wildcircuits/Cobble/Cobble-board-test/fab/Cobble-board-test-F_Cu.dxf

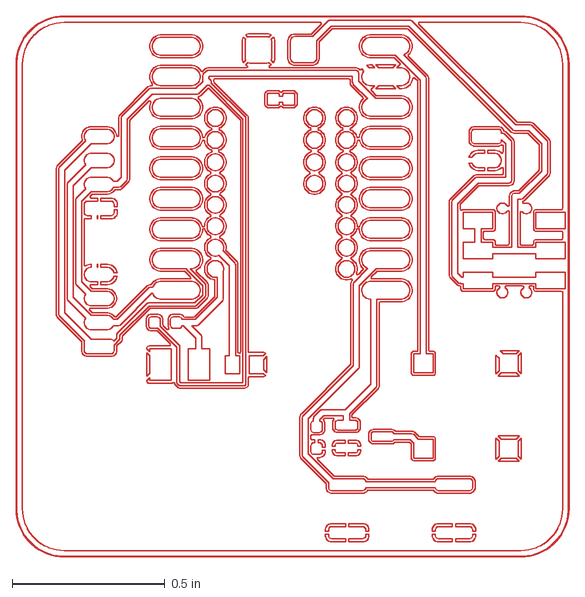
[picture p2: CAD file, 2026-10-19]
Cobble-board-test/fab/Cobble-board-test-F_Cu.dxf
1.81 x 1.77 in
