wildcircuits/Cobble/Cobble-board/fab/Cobble-board-Edge_Cuts.dxf

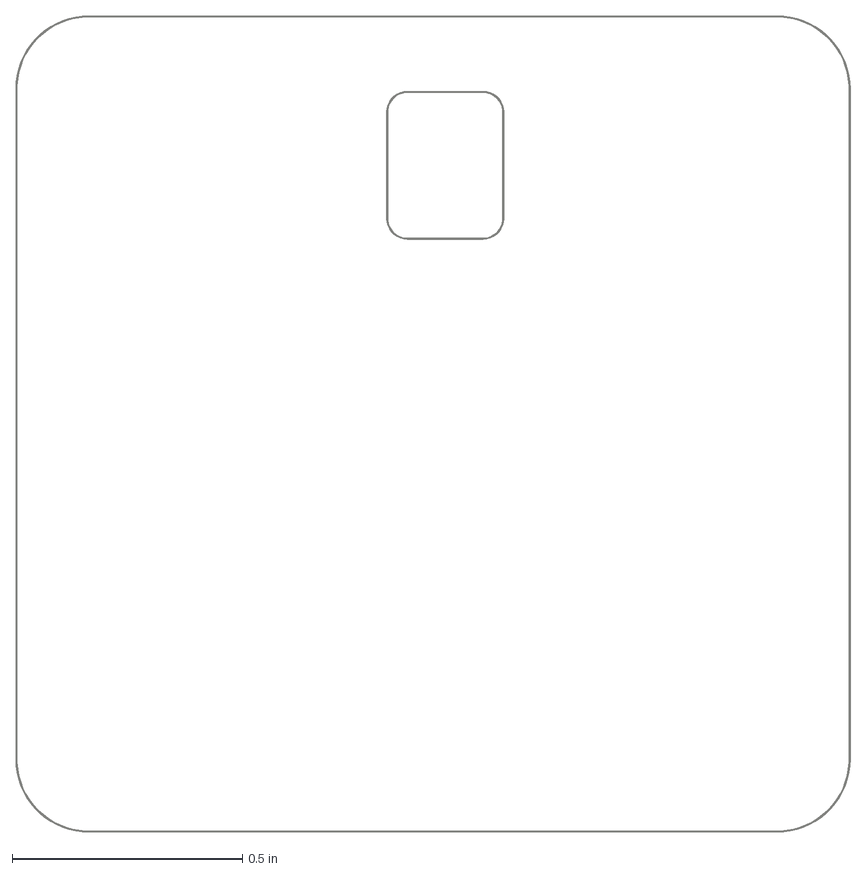
[picture p3: CAD file, 2026-11-10]
Cobble-board/fab/Cobble-board-Edge_Cuts.dxf
1.81 x 1.77 in
