wildcircuits/Cobble/Cobble-board-test/fab/Cobble-board-test-Edge_Cuts.dxf

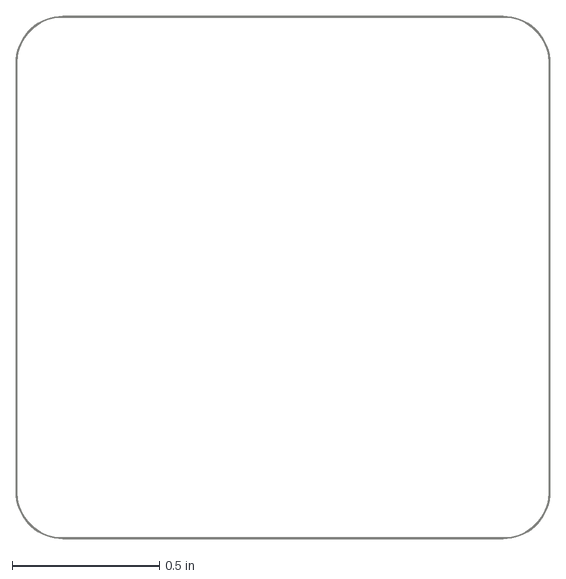
[picture p4: CAD file, 2026-10-12]
Cobble-board-test/fab/Cobble-board-test-Edge_Cuts.dxf
1.81 x 1.77 in
