wildcircuits/Cobble/Cobble-board/fab/Cobble-board-F_Cu.dxf

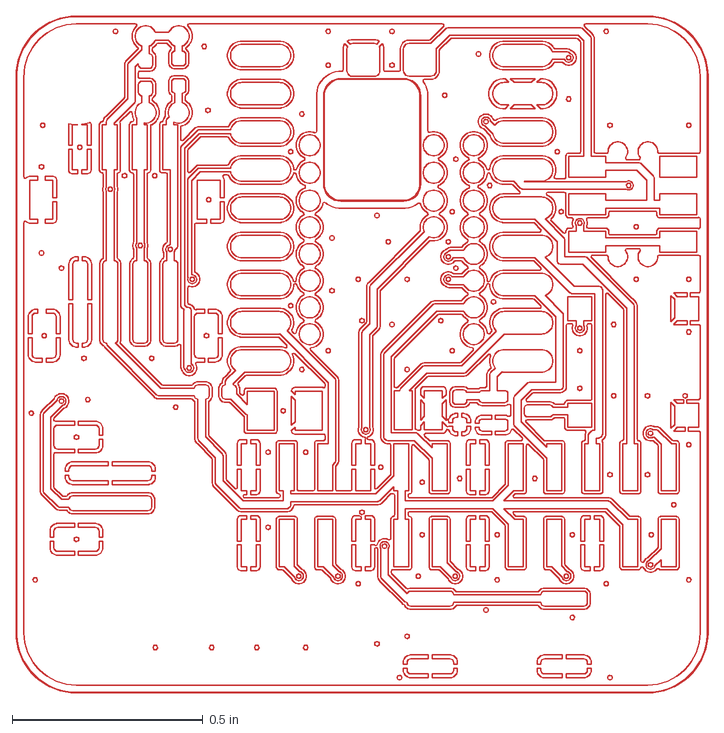
[picture p5: CAD file, 2026-11-10]
Cobble-board/fab/Cobble-board-F_Cu.dxf
1.81 x 1.77 in
