wildcircuits/Cobble/Cobble-board/fab/Cobble-board-B_Cu.dxf

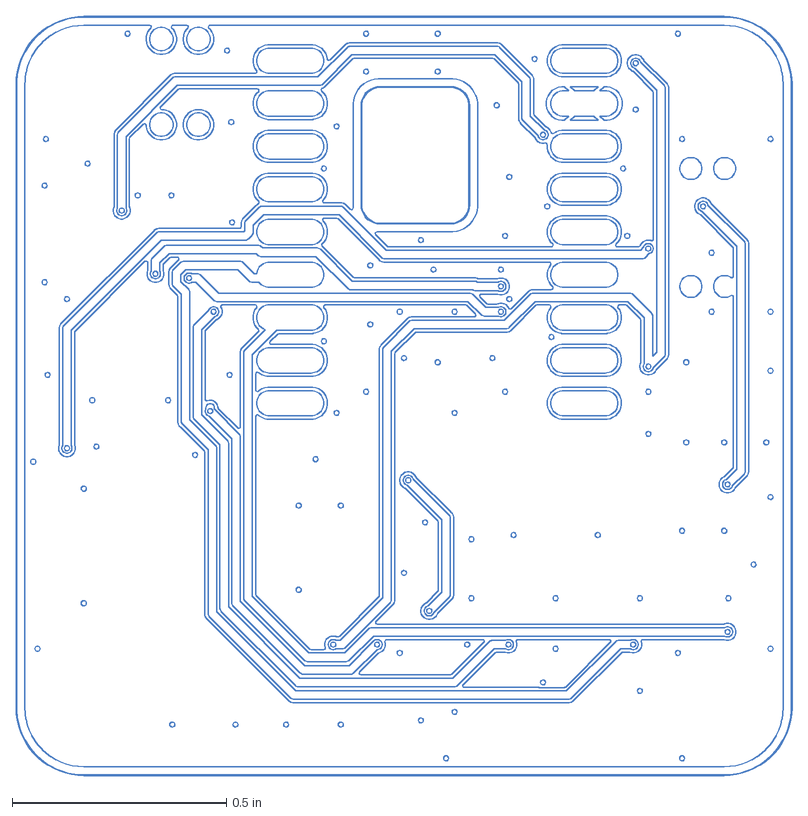
[picture p6: CAD file, 2026-11-10]
Cobble-board/fab/Cobble-board-B_Cu.dxf
1.81 x 1.77 in
