wildcircuits/Cobble/(list of files, cad)

Other CAD files:
Cobble-board-test/fab/Cobble-board-test-F_Paste.dxf
Cobble-board-test/fab/Cobble-board-test-F_Silkscreen.dxf
Cobble-board/fab/Cobble-board-B_Mask.dxf
Cobble-board/fab/Cobble-board-B_Paste.dxf
Cobble-board/fab/Cobble-board-B_Silkscreen.dxf
Cobble-board/fab/Cobble-board-F_Mask.dxf
Cobble-board/fab/Cobble-board-F_Paste.dxf
Cobble-board/fab/Cobble-board-F_Silkscreen.dxf
