wildcircuits/Cobble/Cobble-board-test/Cobble-board-test.pdf

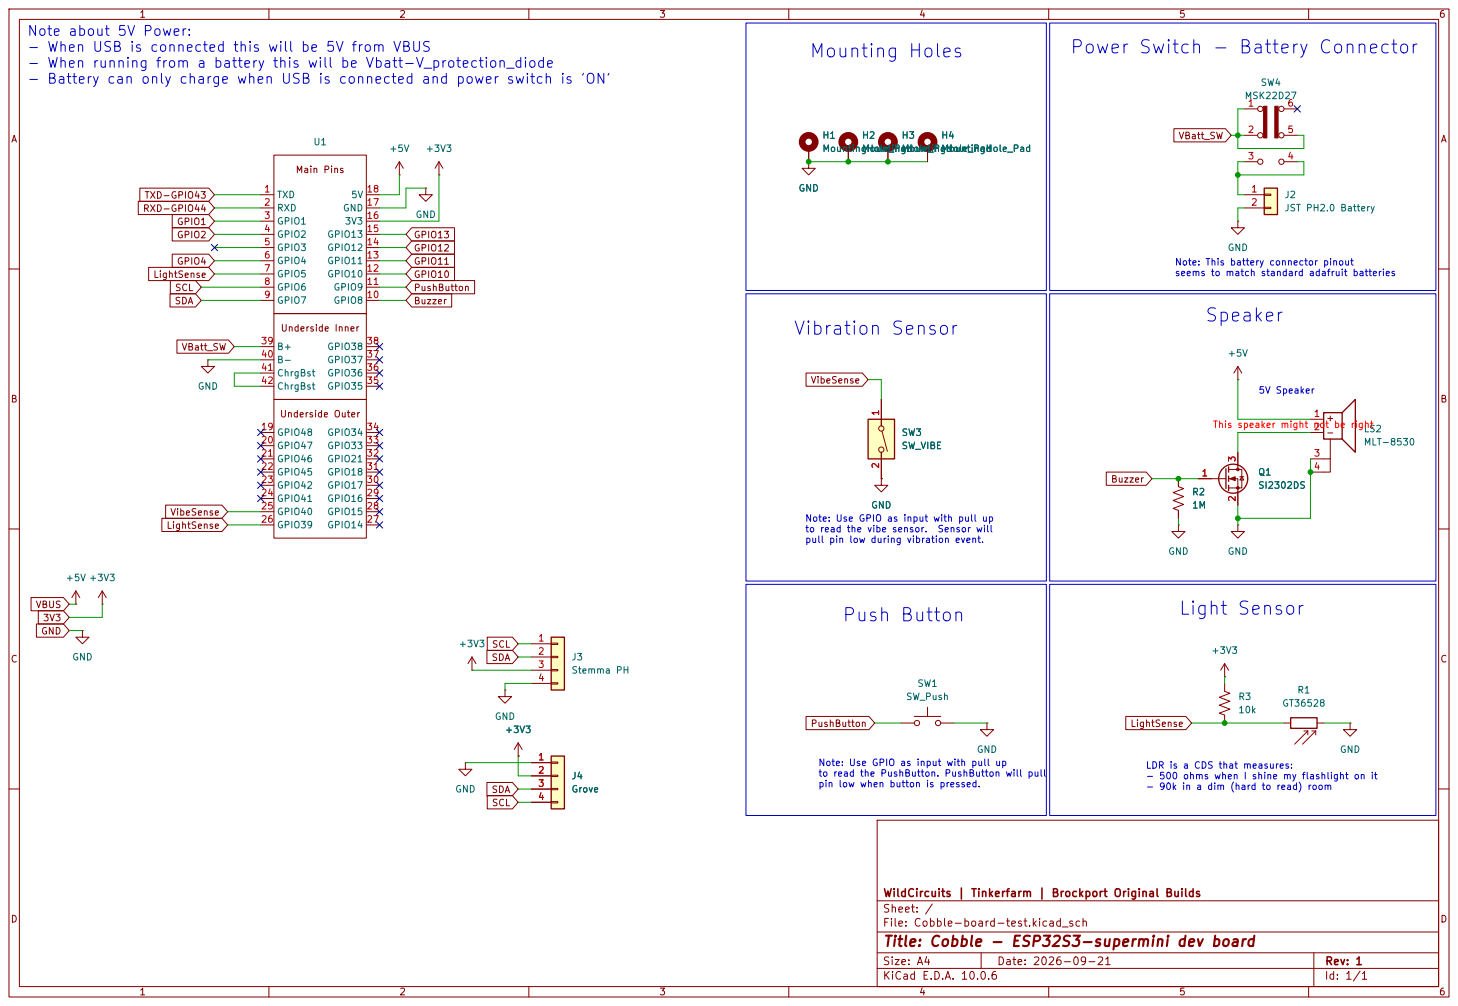
[picture p7: page 1]
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

5V Speaker Note: This battery connector pinout seems to match standard adafruit batteries Power Switch - Battery Connector

to read the vibe sensor. Sensor will pull pin low during vibration event. Vibration Sensor

Note: Use GPIO as input with pull up

to read the PushButton. PushButton will pull

WildCircuits | Tinkerfarm | Brockport Original Builds
Sheet: /
File: Cobble-board-test.kicad_sch
Title: Cobble - ESP32S3-supermini dev board

Size: A4 | Rev: 1
KiCad E.D.A. 10.0.6 | Id: 1/1
