wildcircuits/Cobble/Cobble-board/Cobble-board.kicad_pcb

## KiCad design Cobble-board/Cobble-board.kicad_pcb (2026-11-10)

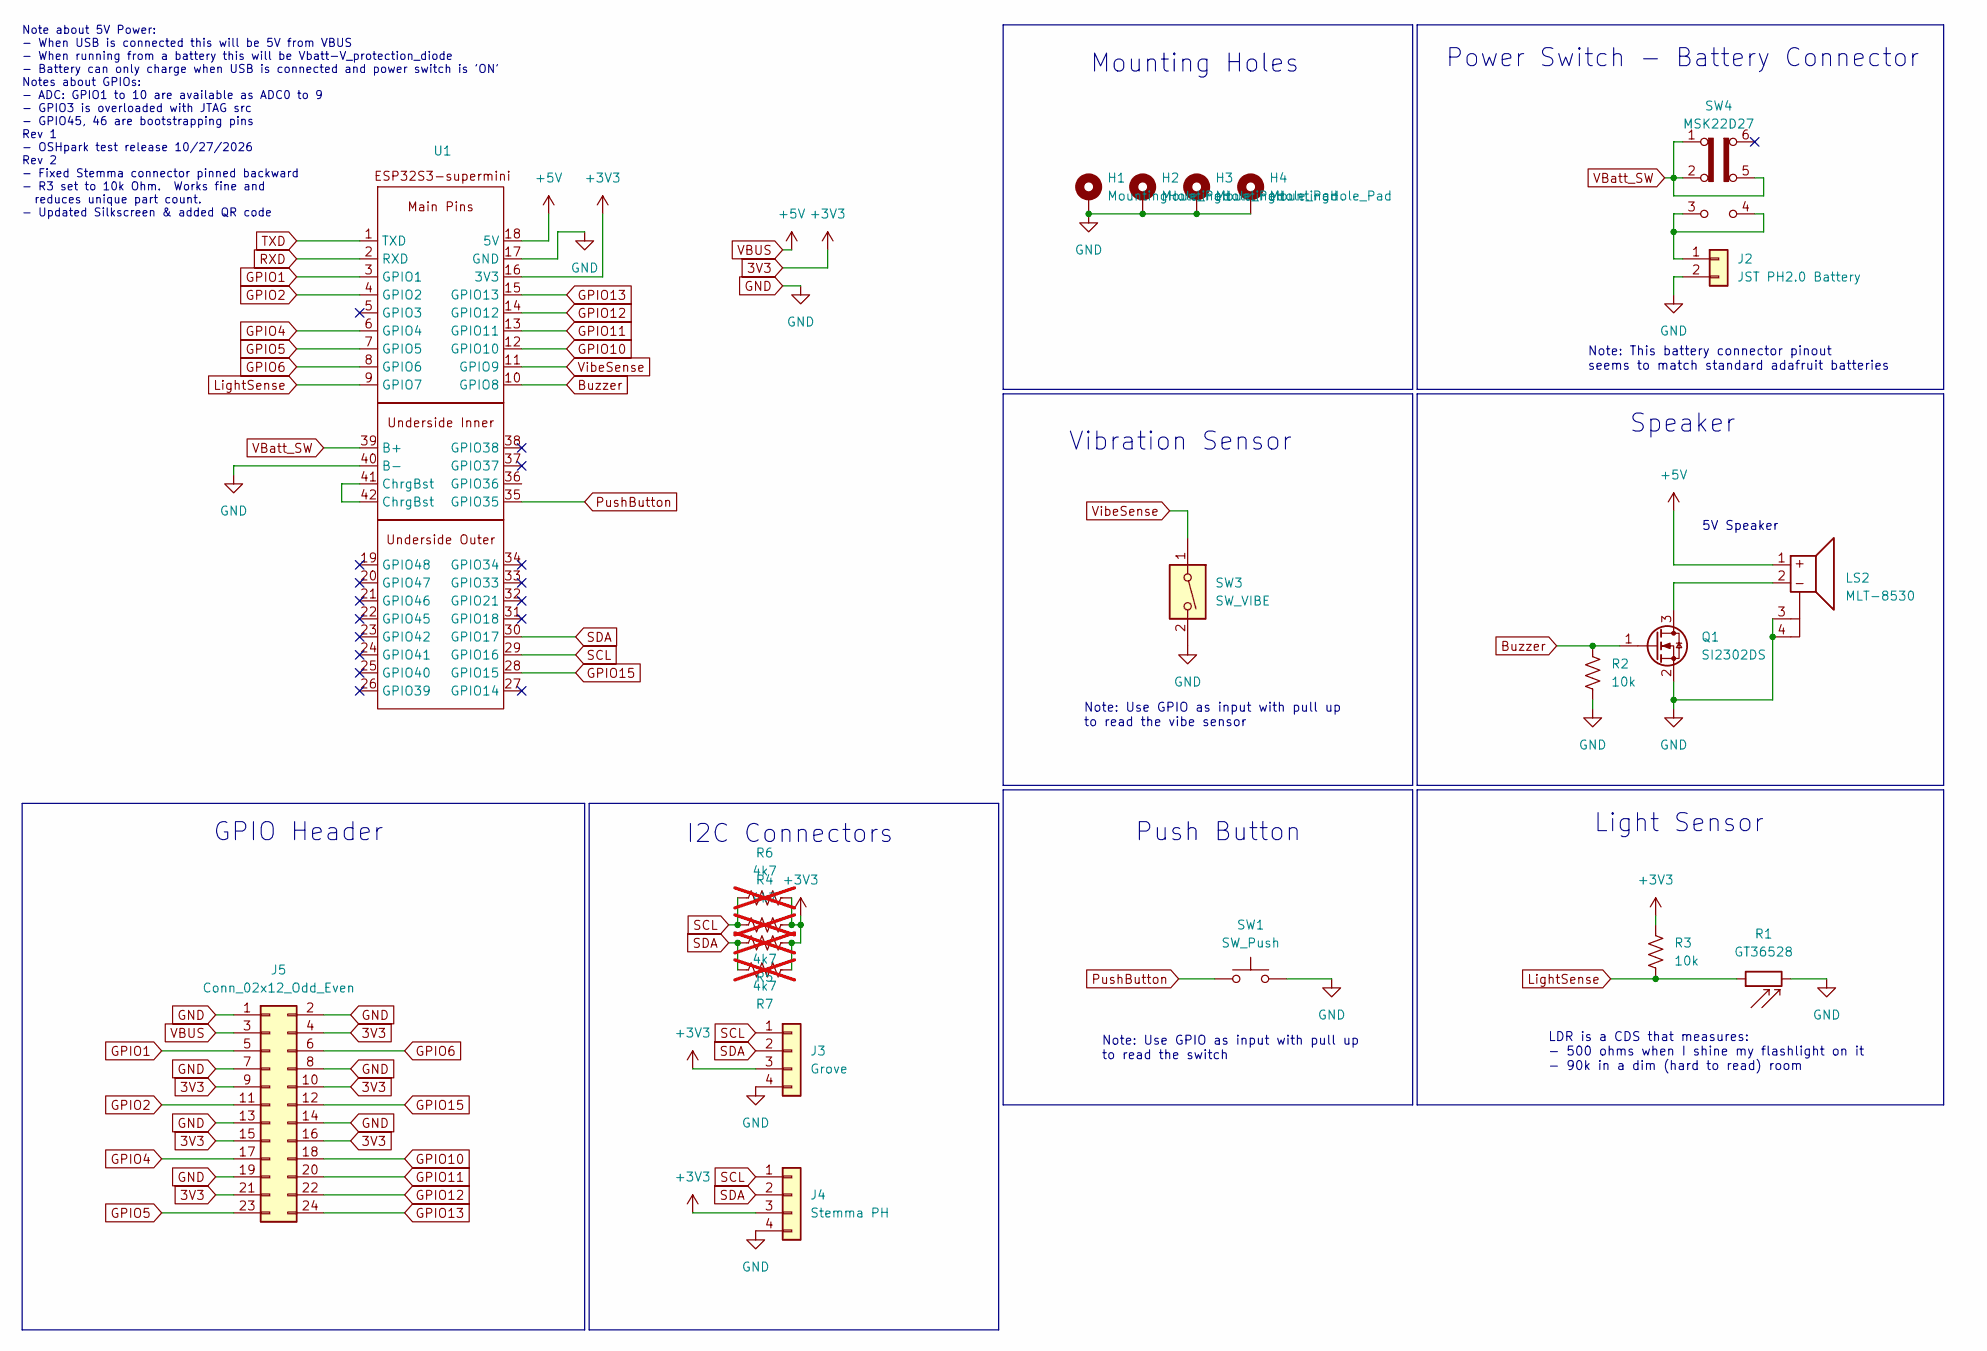
[picture p9: schematic Cobble-board.kicad_sch, Cobble - ESP32S3-supermini dev board]

Parts:
H1, H2, H3, H4: MountingHole_Pad; MountingHole_3.2mm_M3_Pad_TopBottom
J2: JST PH2.0 Battery; JST_PH_B2B-PH-SM4-TB_1x02-1MP_P2.00mm_Vertical
J3: Grove; JST_PH_B4B-PH-SM4-TB_1x04-1MP_P2.00mm_Vertical
J4: Stemma PH; GROVE-HW4-SMD-2.0
J5: Conn_02x12_Odd_Even; PinHeader_2x12_P2.54mm_Vertical_SMD
LS2: MLT-8530
Q1: SI2302DS; SOT-23_Handsoldering
R1: GT36528
R2, R3: 10k; R_0603_1608Metric_Pad0.98x0.95mm_HandSolder
R4, R5: 4k7; R_0603_1608Metric_Pad0.98x0.95mm_HandSolder; not fitted
R6, R7: 4k7; R_Axial_DIN0204_L3.6mm_D1.6mm_P5.08mm_Horizontal; not fitted
SW1: SW_Push; SW_Push_1P1T
SW3: SW_VIBE; X160
SW4: MSK22D27
U1: ESP32S3-supermini-v2

Connections:
3V3: J3.3, J4.3, J5.4, J5.9, J5.10, J5.15, J5.16, J5.21, R3.1, R4.2, R5.2, R6.2, R7.2, U1.16 (3V3)
Buzzer: Q1.1 (G), R2.1, U1.10 (GPIO8)
GND: H1.1 (1_1), H2.1 (1_1), H3.1 (1_1), H4.1 (1_1), J2.2, J2.MP, J3.4, J3.MP, J4.4, J4.5, J4.6, J5.1, J5.2, J5.7, J5.8, J5.13, J5.14, J5.19, LS2.3 (Dummy), LS2.4 (Dummy), Q1.2 (S), R1.2, R2.2, SW1.2, SW3.2, U1.17 (GND), U1.40 (B-)
GPIO1: J5.5, U1.3 (GPIO1)
GPIO2: J5.11, U1.4 (GPIO2)
GPIO4: J5.17, U1.6 (GPIO4)
GPIO5: J5.23, U1.7 (GPIO5)
GPIO6: J5.6, U1.8 (GPIO6)
GPIO10: J5.18, U1.12 (GPIO10)
GPIO11: J5.20, U1.13 (GPIO11)
GPIO12: J5.22, U1.14 (GPIO12)
GPIO13: J5.24, U1.15 (GPIO13)
GPIO15: J5.12, U1.28 (GPIO15)
LightSense: R1.1, R3.2, U1.9 (GPIO7)
unnamed: J2.1, SW4.3 (C), SW4.4 (A)
unnamed: LS2.2, Q1.3 (D)
PushButton: SW1.1, U1.35 (GPIO35)
RXD: U1.2 (RXD)
SCL: J3.1, J4.1, R4.1, R6.1, U1.29 (GPIO16)
SDA: J3.2, J4.2, R5.1, R7.1, U1.30 (GPIO17)
TXD: U1.1 (TXD)
VBUS: J5.3, LS2.1, U1.18 (5V)
VBatt_SW: SW4.1 (A), SW4.2 (B), SW4.5 (B), U1.39 (B+)
VibeSense: SW3.1, U1.11 (GPIO9)

Notes on the sheet:
Note: Use GPIO as input with pull up to read the switch
Note: This battery connector pinout seems to match standard adafruit batteries
5V Speaker
LDR is a CDS that measures: - 500 ohms when I shine my flashlight on it - 90k in a dim (hard to read) room
Mounting Holes
I2C Connectors
Vibration Sensor
Speaker
Note: Use GPIO as input with pull up to read the vibe sensor
Note about 5V Power: - When USB is connected this will be 5V from VBUS - When running from a battery this will be Vbatt-V_protection_diode - Battery can only charge when USB is connected and power switch is 'ON' Notes about GPIOs: - ADC: GPIO1 to 10 are available as ADC0 to 9 - GPIO3 is overloaded 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
Push Button
GPIO Header
Light Sensor
Power Switch - Battery Connector

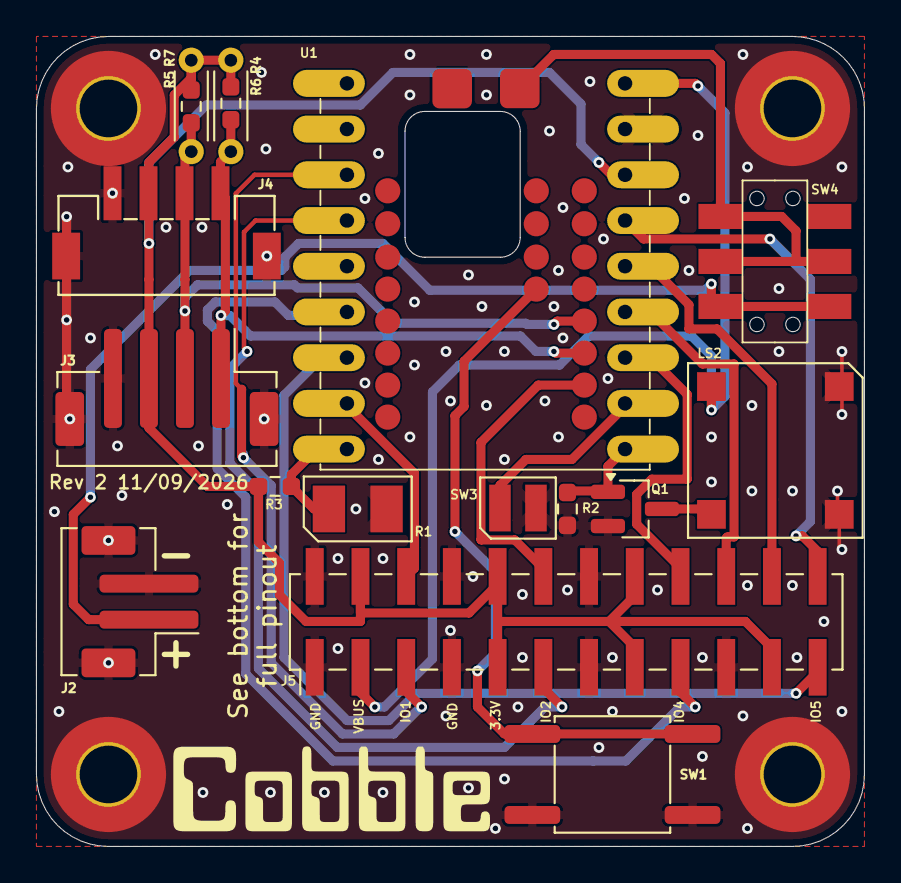
[picture p10: board Cobble-board.kicad_pcb from above]

Board: 2 copper layers, 46.0 x 45.0 mm, 21 parts (0 on the bottom side), 22 nets.
