wildcircuits/Cobble/Cobble-board-test/Cobble-board-test.kicad_pcb

## KiCad design Cobble-board-test/Cobble-board-test.kicad_pcb (2026-10-19)

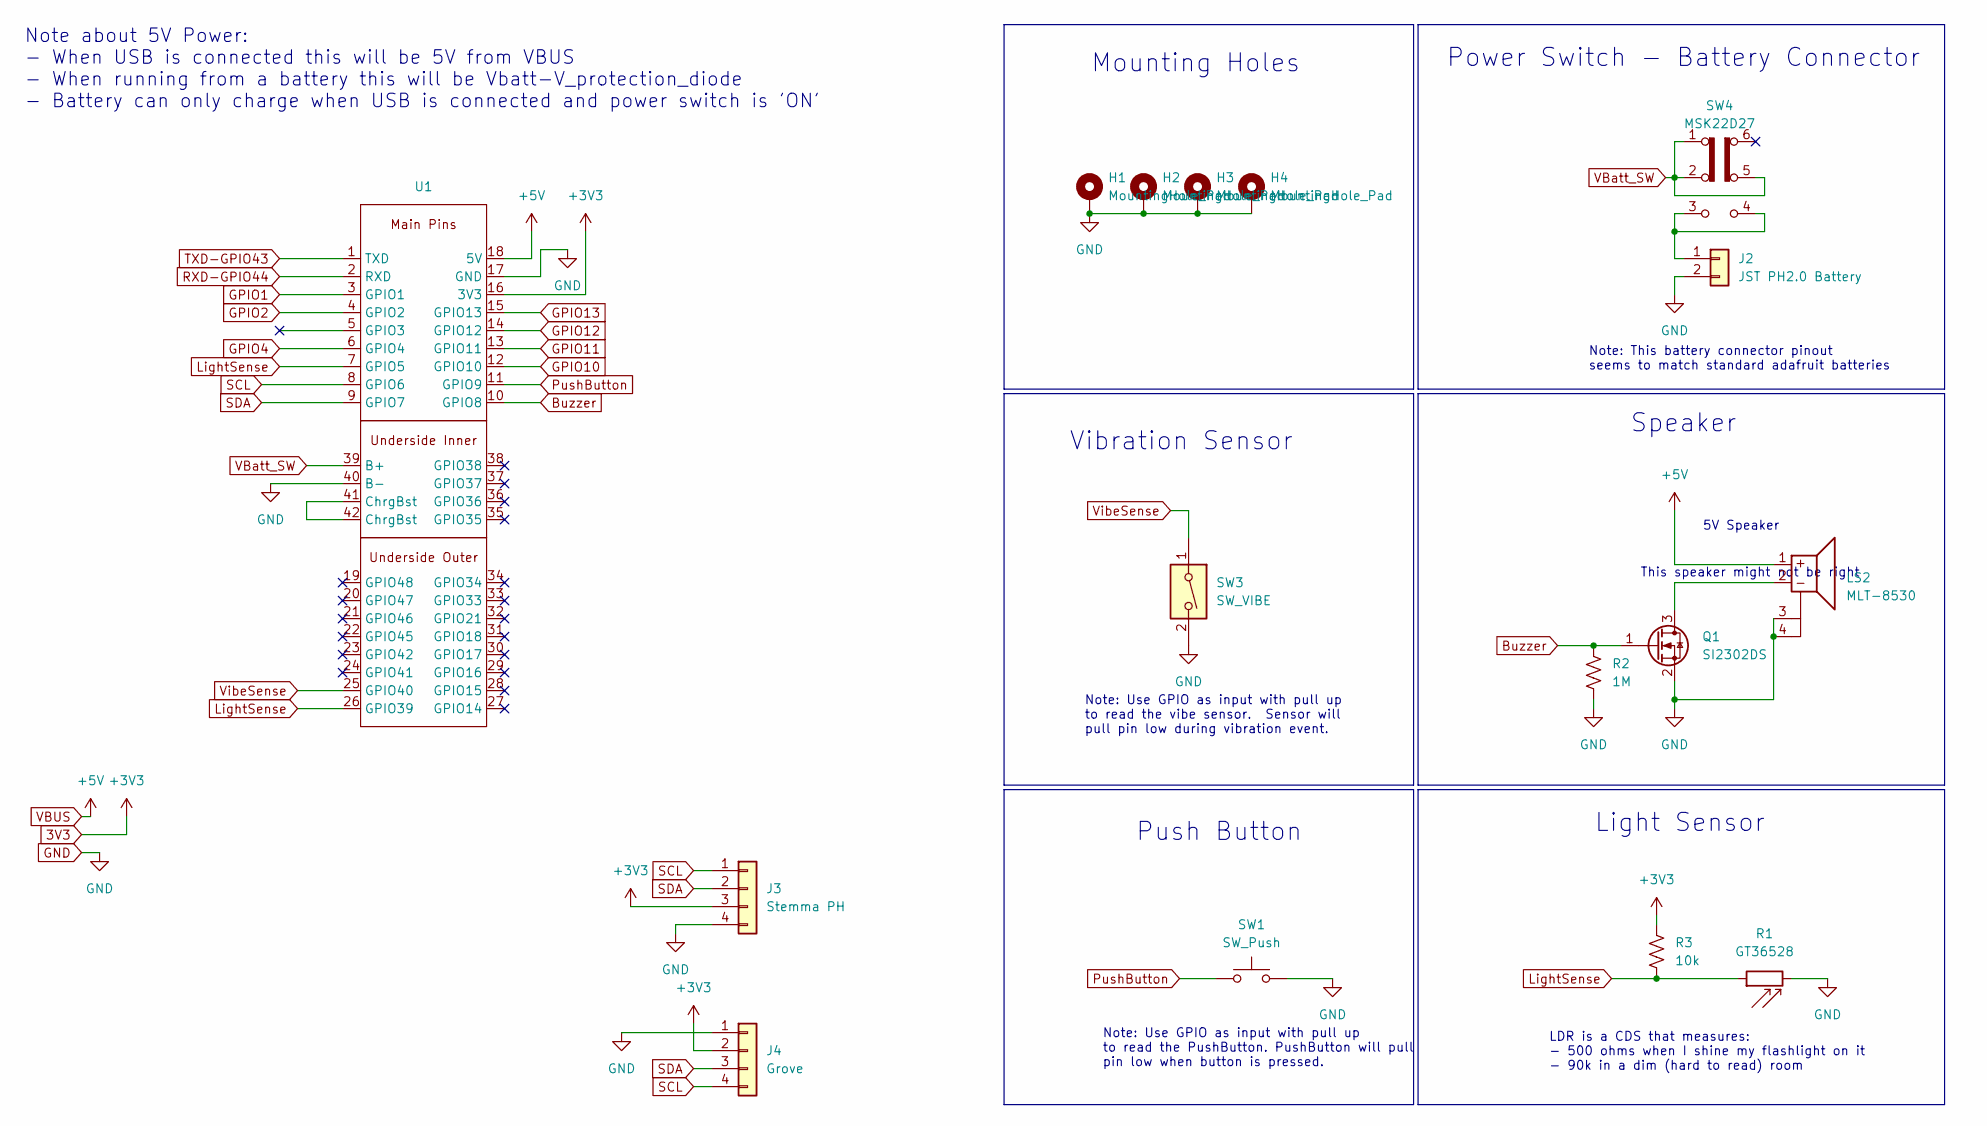
[picture p11: schematic Cobble-board-test.kicad_sch, Cobble - ESP32S3-supermini dev board]

Parts:
H1, H2, H3, H4: MountingHole_Pad; MountingHole_3.2mm_M3_Pad_TopBottom
J2: JST PH2.0 Battery; Battery_1x02_P2.00mm_Horizontal
J3: Stemma PH; Stemma_Grove_1x04_P2.00mm_Horizontal
J4: Grove; Stemma_Grove_1x04_P2.00mm_Horizontal
LS2: MLT-8530
Q1: SI2302DS; SOT-23_Handsoldering
R1: GT36528
R2: 1M; R_0603_1608Metric_Pad0.98x0.95mm_HandSolder
R3: 10k; R_0603_1608Metric_Pad0.98x0.95mm_HandSolder
SW1: SW_Push; SW_Push_1P1T_NO_CK_KSC6xxG
SW3: SW_VIBE; X160
SW4: MSK22D27
U1: ESP32S3-supermini

Connections:
3V3: J3.3, J4.2, R3.1, U1.16 (3V3)
Buzzer: Q1.1 (G), R2.1, U1.10 (GPIO8)
GND: H1.1 (1_1), H2.1 (1_1), H3.1 (1_1), H4.1 (1_1), J2.2, J3.4, J4.1, LS2.3 (Dummy), LS2.4 (Dummy), Q1.2 (S), R1.2, R2.2, SW1.2, SW3.2, U1.17 (GND), U1.40 (B-)
GPIO1: U1.3 (GPIO1)
GPIO2: U1.4 (GPIO2)
GPIO4: U1.6 (GPIO4)
GPIO10: U1.12 (GPIO10)
GPIO11: U1.13 (GPIO11)
GPIO12: U1.14 (GPIO12)
GPIO13: U1.15 (GPIO13)
unnamed: J2.1, SW4.3 (C), SW4.4 (A)
unnamed: LS2.2, Q1.3 (D)
unnamed: U1.41 (ChrgBst), U1.42 (ChrgBst)
PushButton: SW1.1, U1.11 (GPIO9)
RXD-GPIO44: U1.2 (RXD)
SCL: J3.1, J4.4, U1.8 (GPIO6)
SDA: J3.2, J4.3, U1.9 (GPIO7)
TXD-GPIO43: U1.1 (TXD)
VBUS: LS2.1, U1.18 (5V)
VBatt_SW: SW4.1 (A), SW4.2 (B), SW4.5 (B), U1.39 (B+)
VibeSense: SW3.1, U1.25 (GPIO40)

Notes on the sheet:
This speaker might not be right
Note: Use GPIO as input with pull up to read the PushButton. PushButton will pull pin low when button is pressed.
Note: This battery connector pinout seems to match standard adafruit batteries
5V Speaker
LDR is a CDS that measures: - 500 ohms when I shine my flashlight on it - 90k in a dim (hard to read) room
Mounting Holes
Vibration Sensor
Speaker
Note: Use GPIO as input with pull up to read the vibe sensor. Sensor will pull pin low during vibration event.
Note about 5V Power: - When USB is connected this will be 5V from VBUS - When running from a battery this will be Vbatt-V_protection_diode - Battery can only charge when USB is connected and power switch is 'ON'
Push Button
Light Sensor
Power Switch - Battery Connector

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
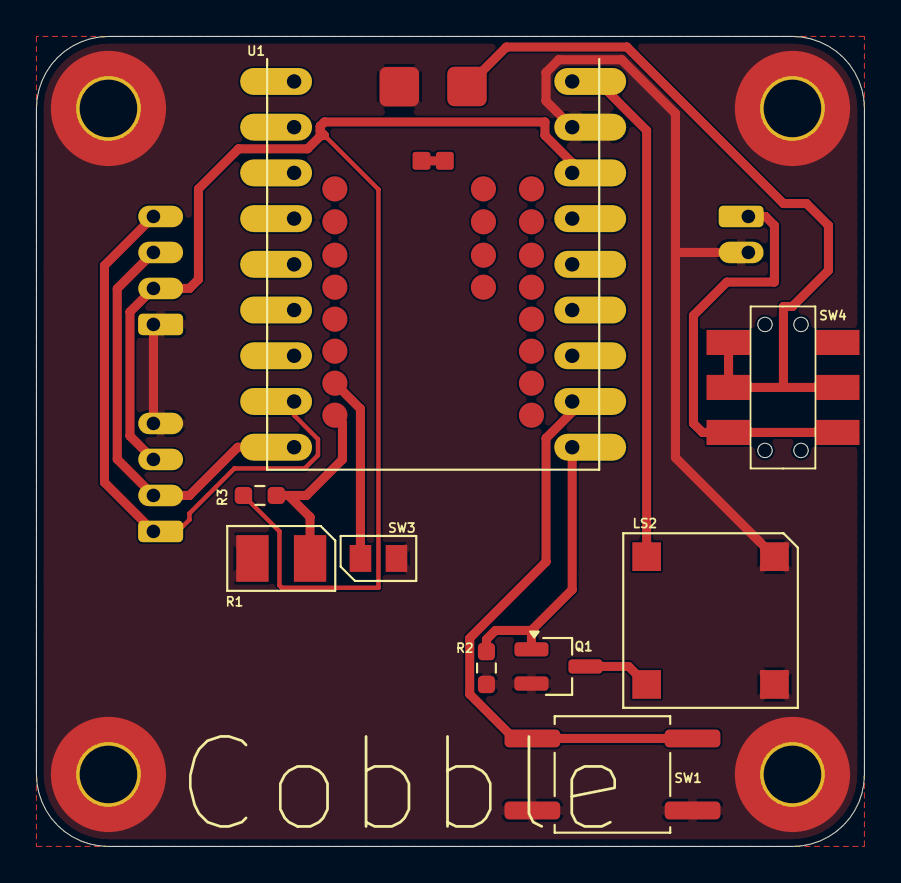
[picture p12: board Cobble-board-test.kicad_pcb from above]

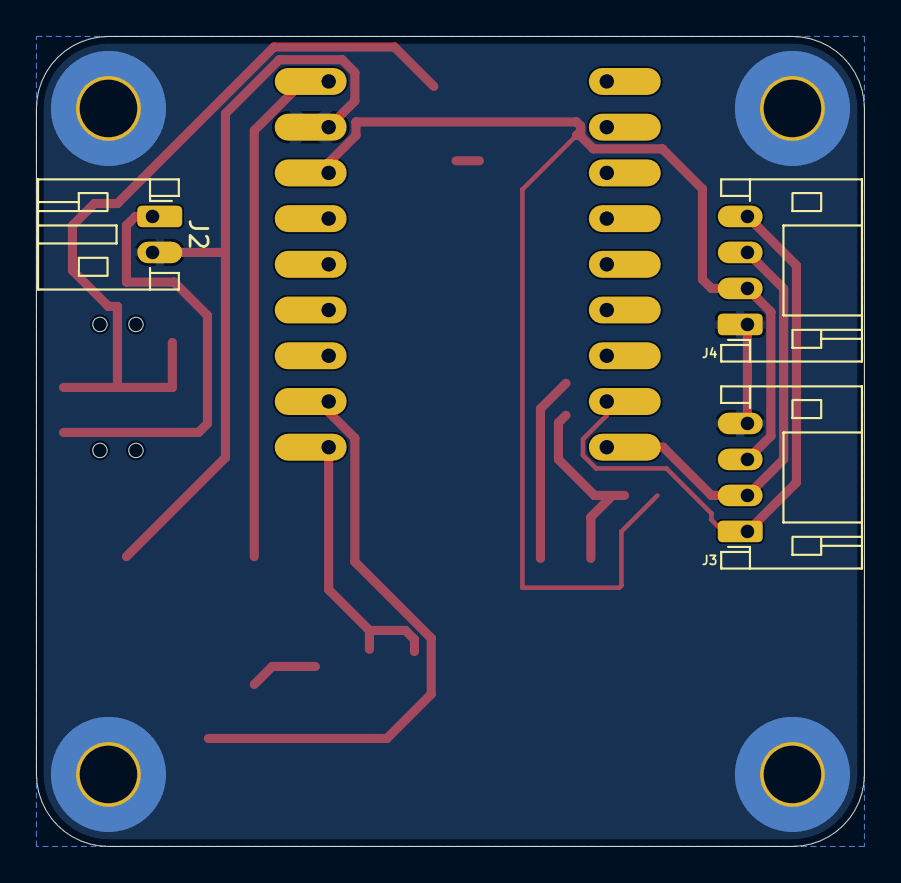
[picture p13: board Cobble-board-test.kicad_pcb from below]

Board: 2 copper layers, 46.0 x 45.0 mm, 16 parts (3 on the bottom side), 13 nets.
