wildcircuits/Cobble/(commit log)

2026-09-22 initial commit with ESP32S3-supermini footprint
    [Cobble-board.kicad_pcb, Cobble-board.kicad_sch]
2026-09-22 Added a pinout for the ESP board
2026-10-10 added most components. waiting on clarification for speaker and i2c connectors
2026-10-12 main PWB is nearly complete. need to add logo and fix one rat line. added a cobble-board-test for a simpler single sided fab test board
2026-10-19 Cobbl-board-test is complete and tested
2026-10-19 updated README.md with info about Cobble-board-test
2026-10-20 updated readme for AI assisted code generation. added a default circuipython test script for the cobble-board-test
2026-10-26 Cobble schematic is updated with changes identified from Cobble-board-test. issues fixed: vibe sensor pad too small, SW1 pin spacing wrong, light sensor wired to non-ADC pin, 4 spins on ADC header fo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
2026-10-26 schemtic updated for ESP32-C6 board, but we have decided not to use that version due to usability issues
2026-10-27 Cobble board is rev 1 is ready for review
2026-11-10 Rev2 release ready for fab. Gerbers are in /Cobble-board/fab. Fixed the Stemma connector which was pinned backwards. Set R3 to 10k - it was fine at 1M but works at 10k as well, this reduces the uniqu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
2026-11-10 added BOM at Cobble-board/Cobble-board.csv, updated README
